ragulganesh1001/Robotic-Arm-For-Nes-Power-Glove/reports/MESDP 305 Expo presentation Slideshow.pdf

# SDP 305: Robotic Arm For NES Power Glove

Maxine Krueger, Nicholas Marzan, John Milham, Ragul Ganesh Anitha Palanivel

Faculty Advisor: Dr. Jaeho Lee

5/2/2025

## What is the NES Power Glove?

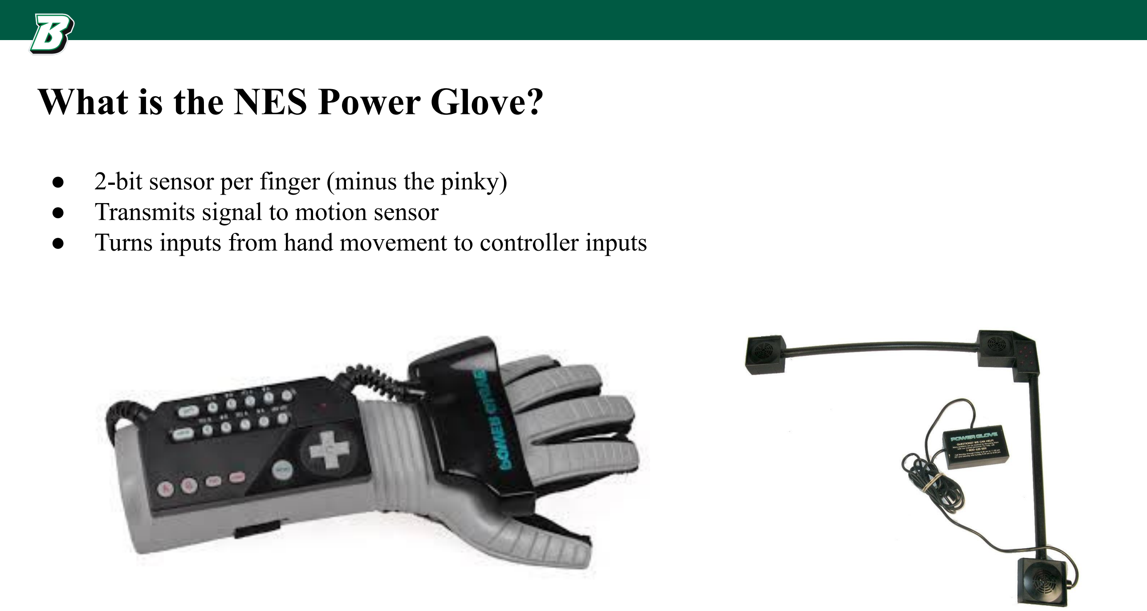
[picture p1: page 2]

- 2-bit sensor per finger (minus the pinky)
- Transmits signal to motion sensor
- Turns inputs from hand movement to controller inputs

## Project Concept

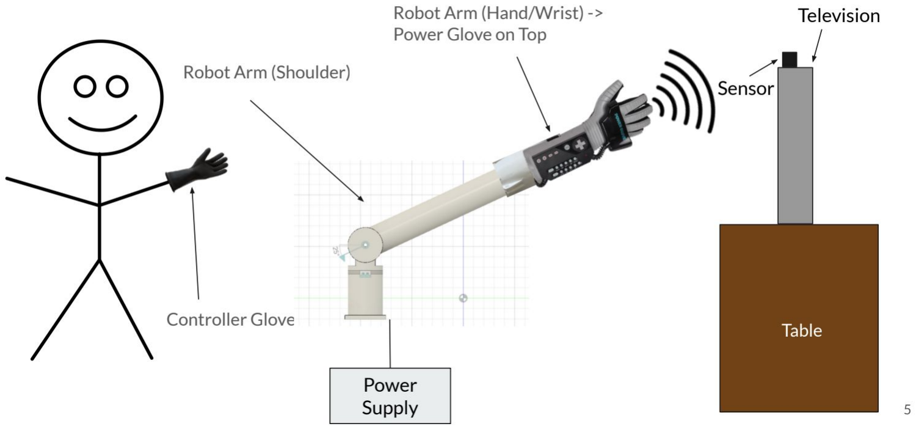
[picture p2: figure]

## Last Years Design - ECD 416

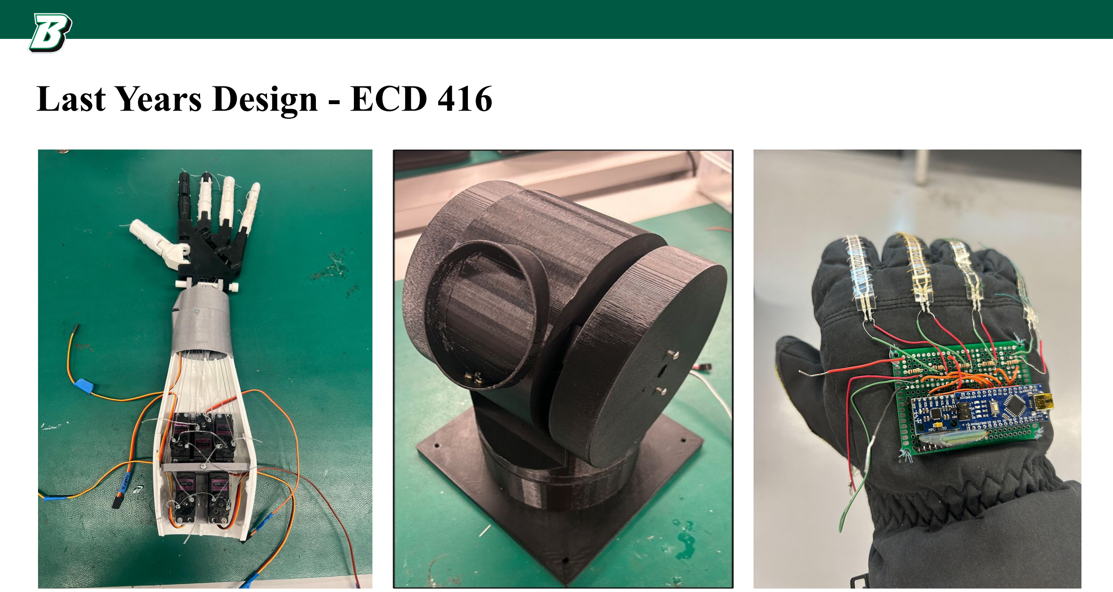
[picture p3: page 4]

## Project Requirements and Specifications

Specifications:

- [MESDP-305-01] The robotic arm fingers shall extend outwards to 180 degrees.
- [MESDP-305-02] The robotic arm fingers shall curl 90 degrees to each joint on the finger.
- [MESDP-305-03] Wrist mechanism of the arm shall rotate +/- 90 degrees.
- [MESDP-305-04] The arm pitch shall be +/- 90 degrees.
- [MESDP-305-05] The arm yaw shall be +/- 90 degrees.
- [MESDP-305-06] The arm shall fit the NES power glove.
- [MESDP-305-07] Movement of the arm shall be uninterrupted.

Requirements:

- To fix the issues present in arm and shoulder parts of last years design.
- Arm controller is designated to ECE 526.

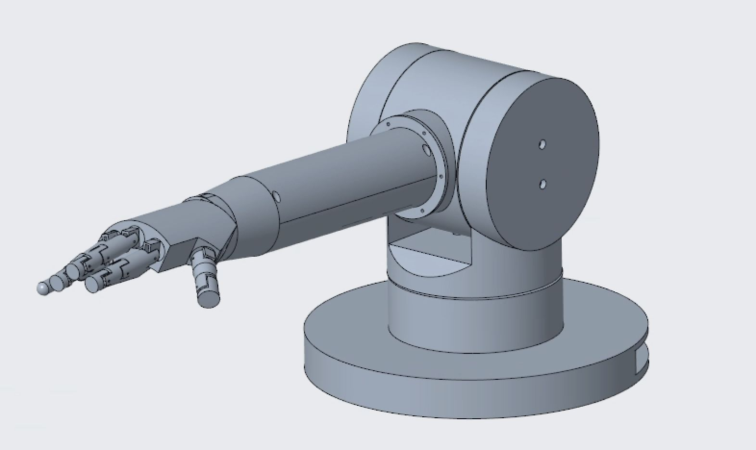
[picture p4: figure]
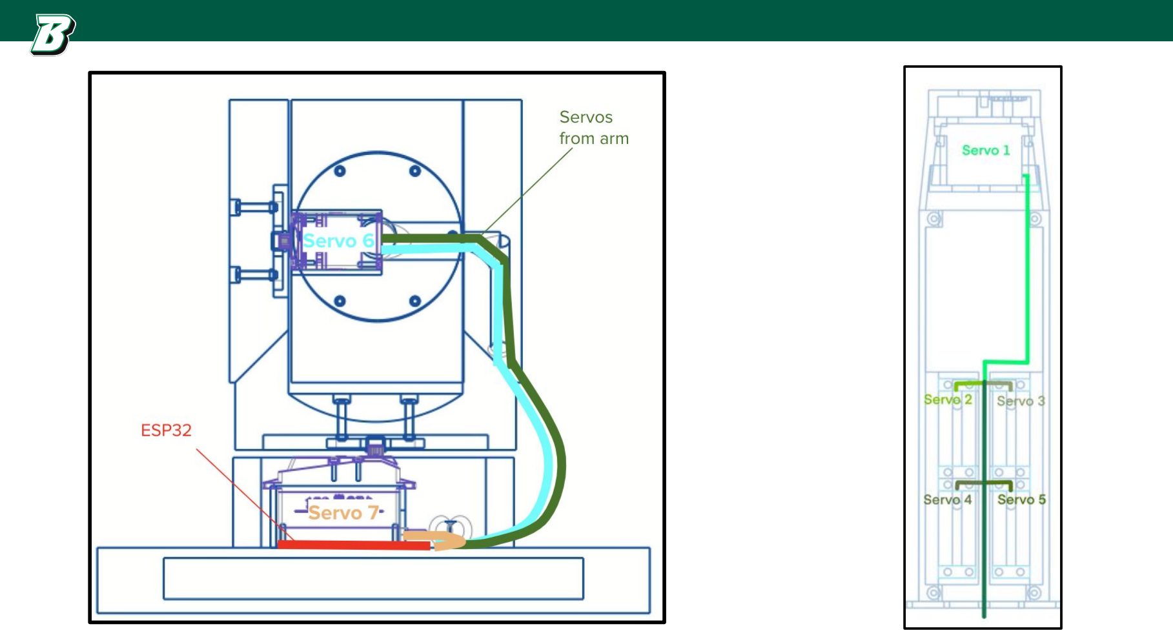
[picture p5: page 7]
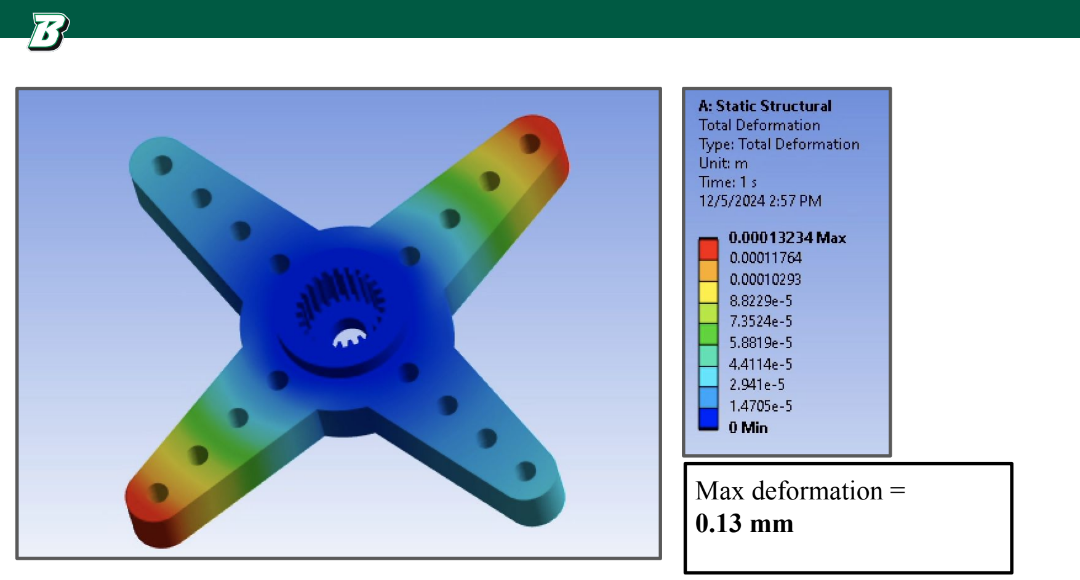
[picture p6: page 8]

Max deformation =

### 0.13 mm

# Moving Parts

## 3 Main Systems

## 1) Wrist Rotation

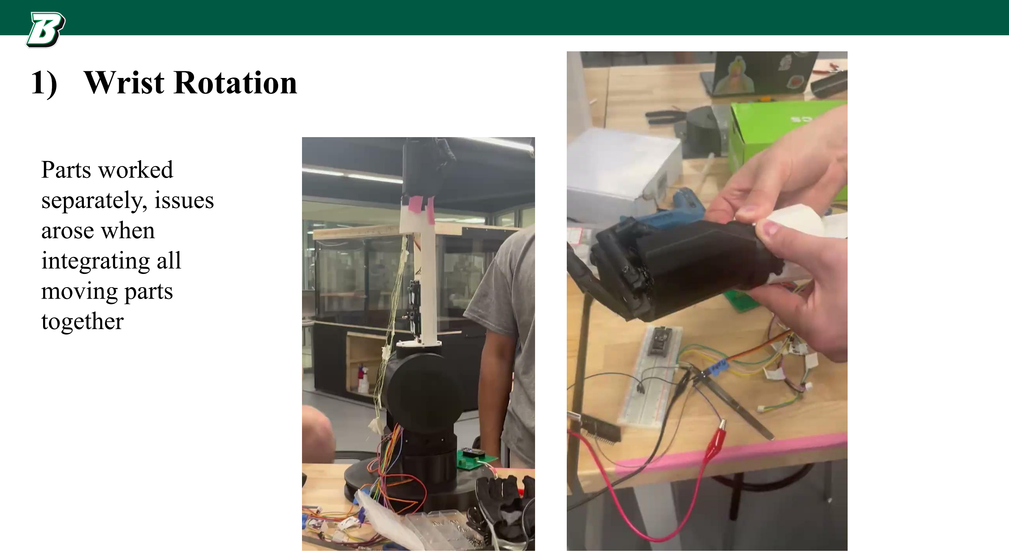
[picture p7: page 10]

Parts worked
separately, issues
arose when
integrating all
moving parts
together

## 2) Finger Movement

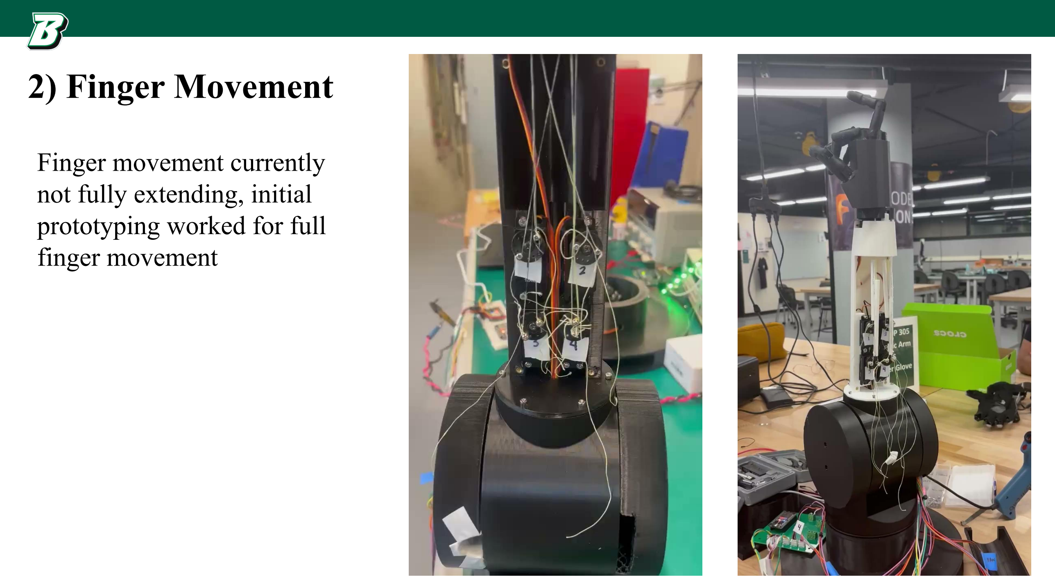
[picture p8: page 11]

Finger movement currently
not fully extending, initial prototyping worked for full finger movement

## 3) Shoulder Movement

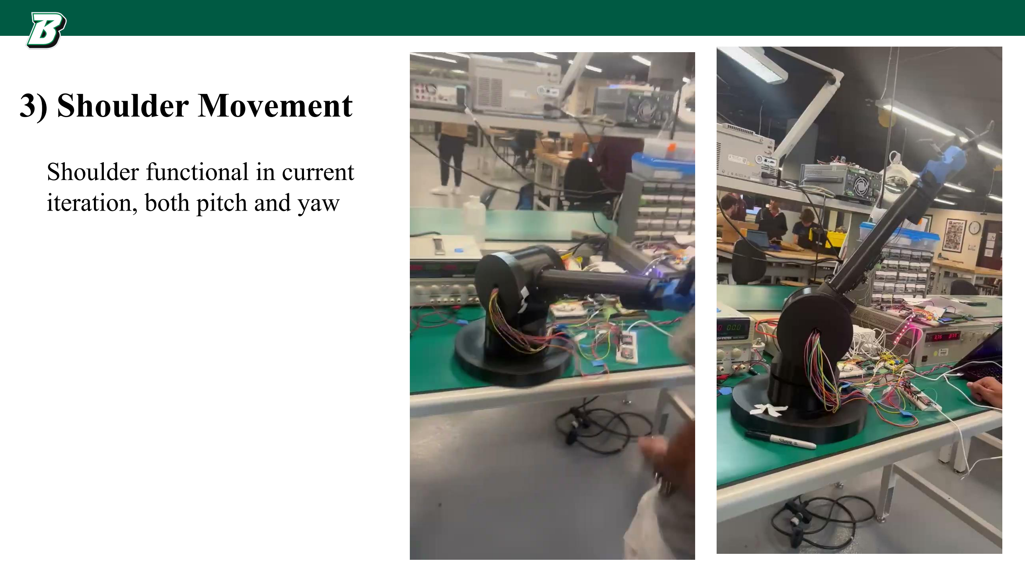
[picture p9: page 12]

Shoulder functional in current iteration, both pitch and yaw

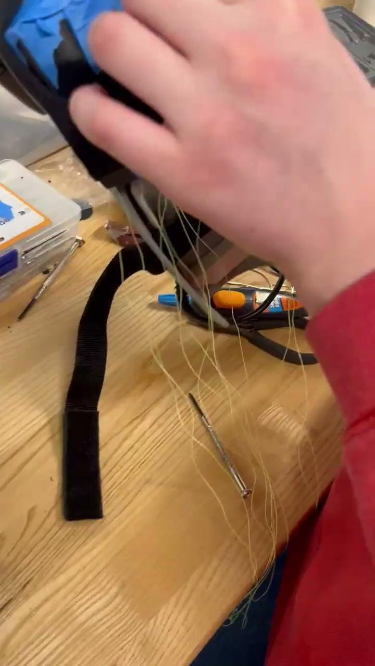
[picture p10: figure]

## Glove Fitting

The power glove fitting over the hand

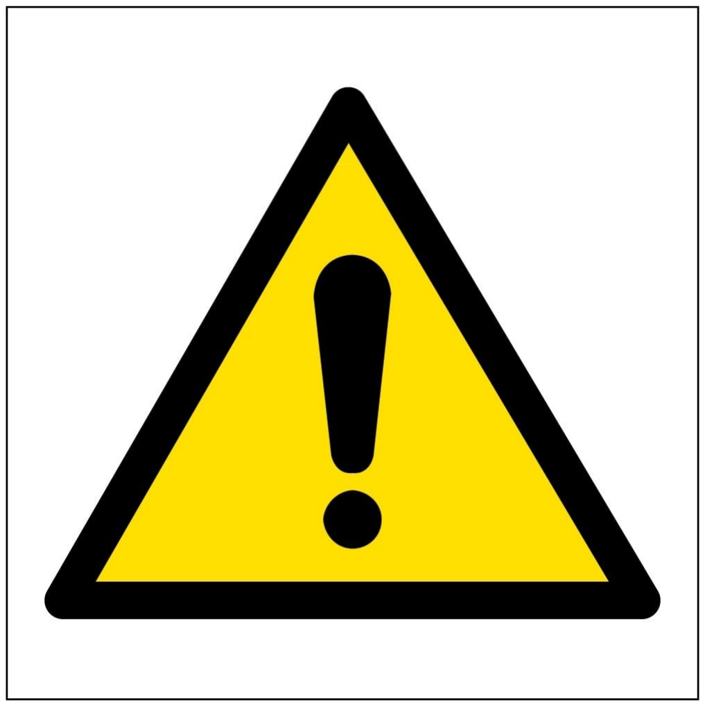
[picture p11: figure]

## Issues

- Wrist and fingers could not operate at the same time, too much tension in the finger lines
- Unable to integrate with ECD 526 transmitter glove due to unsuccessful build
- Multiple broken parts

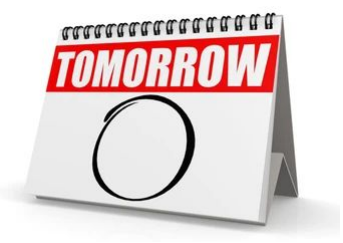
[picture p12: figure]

## Future Improvements

### - Move wrist rotation into base of forearm - Continue current finger movement plan, requires finer calibration
