ragulganesh1001/Robotic-Arm-For-Nes-Power-Glove/reports/project delivery sign-off .pdf

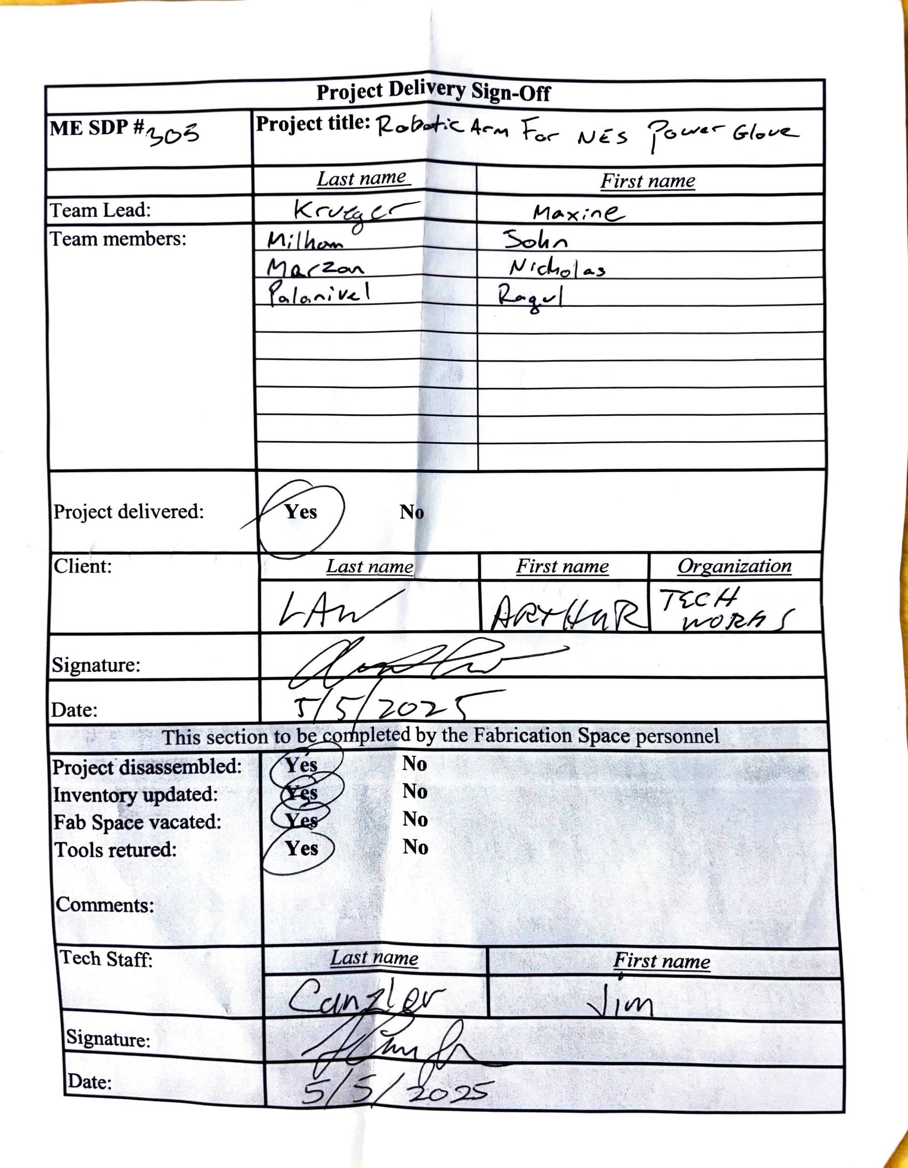
[picture p13: page 1]

ME SOP #.~c,~

Team Lead:
Team members:

Project delivered:

Client:

Signature:

Date:

Project Delivery Sign-Off
Project title: ,Zo,P~~<- 4rNI ,..-
roe-

Last name

No

First name

First name Organization

### TT,cfl

| • rJ~h
This section | pleted by the Fabrica\)on:Space·.personnel
Project-disassembled:.
Inventory updated: •
Fab Space vacated:
Tools retured:

Comments:

Tech Staff:

Signature:

Date:

_,,: .No
No
No ..
No · .·,

' ,._, First name

j
