ragulganesh1001/Robotic-Arm-For-Nes-Power-Glove/reports/ECDME305 system verification.pdf

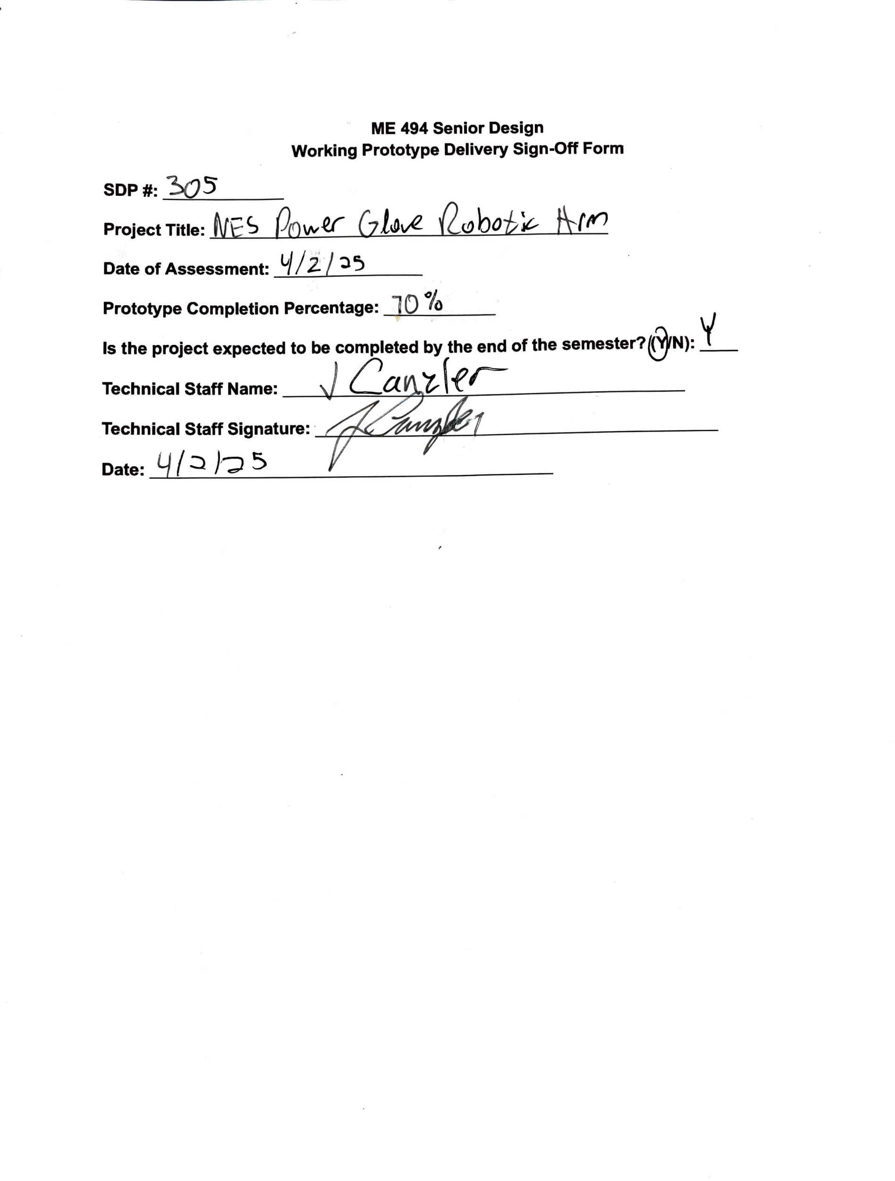
[picture p14: page 1]

ME 494 Senior Design
Working Prototype Delivery Sign-Off Form

SDP#: ~ 5 -=-----
ProjectTitle: Ives P0wif (zli.0v€- {2e,bo-b? t\--rn

Date of Assessment: v/ / i / :l 5

Prototype Completion Percentage: 10 °/0
Is the project expected to be completed by the end of the semester?&N): 'j__

Technical Staff Name: Ca t { f,

Technical Staff Signature: 1.,a£~~~~~ · ---------

# Date: L/ / :) ),:;; ~
